Yoshiharu1962/ForestDesign-Mori-1/MORI_ICHI_1_SCH.pdf

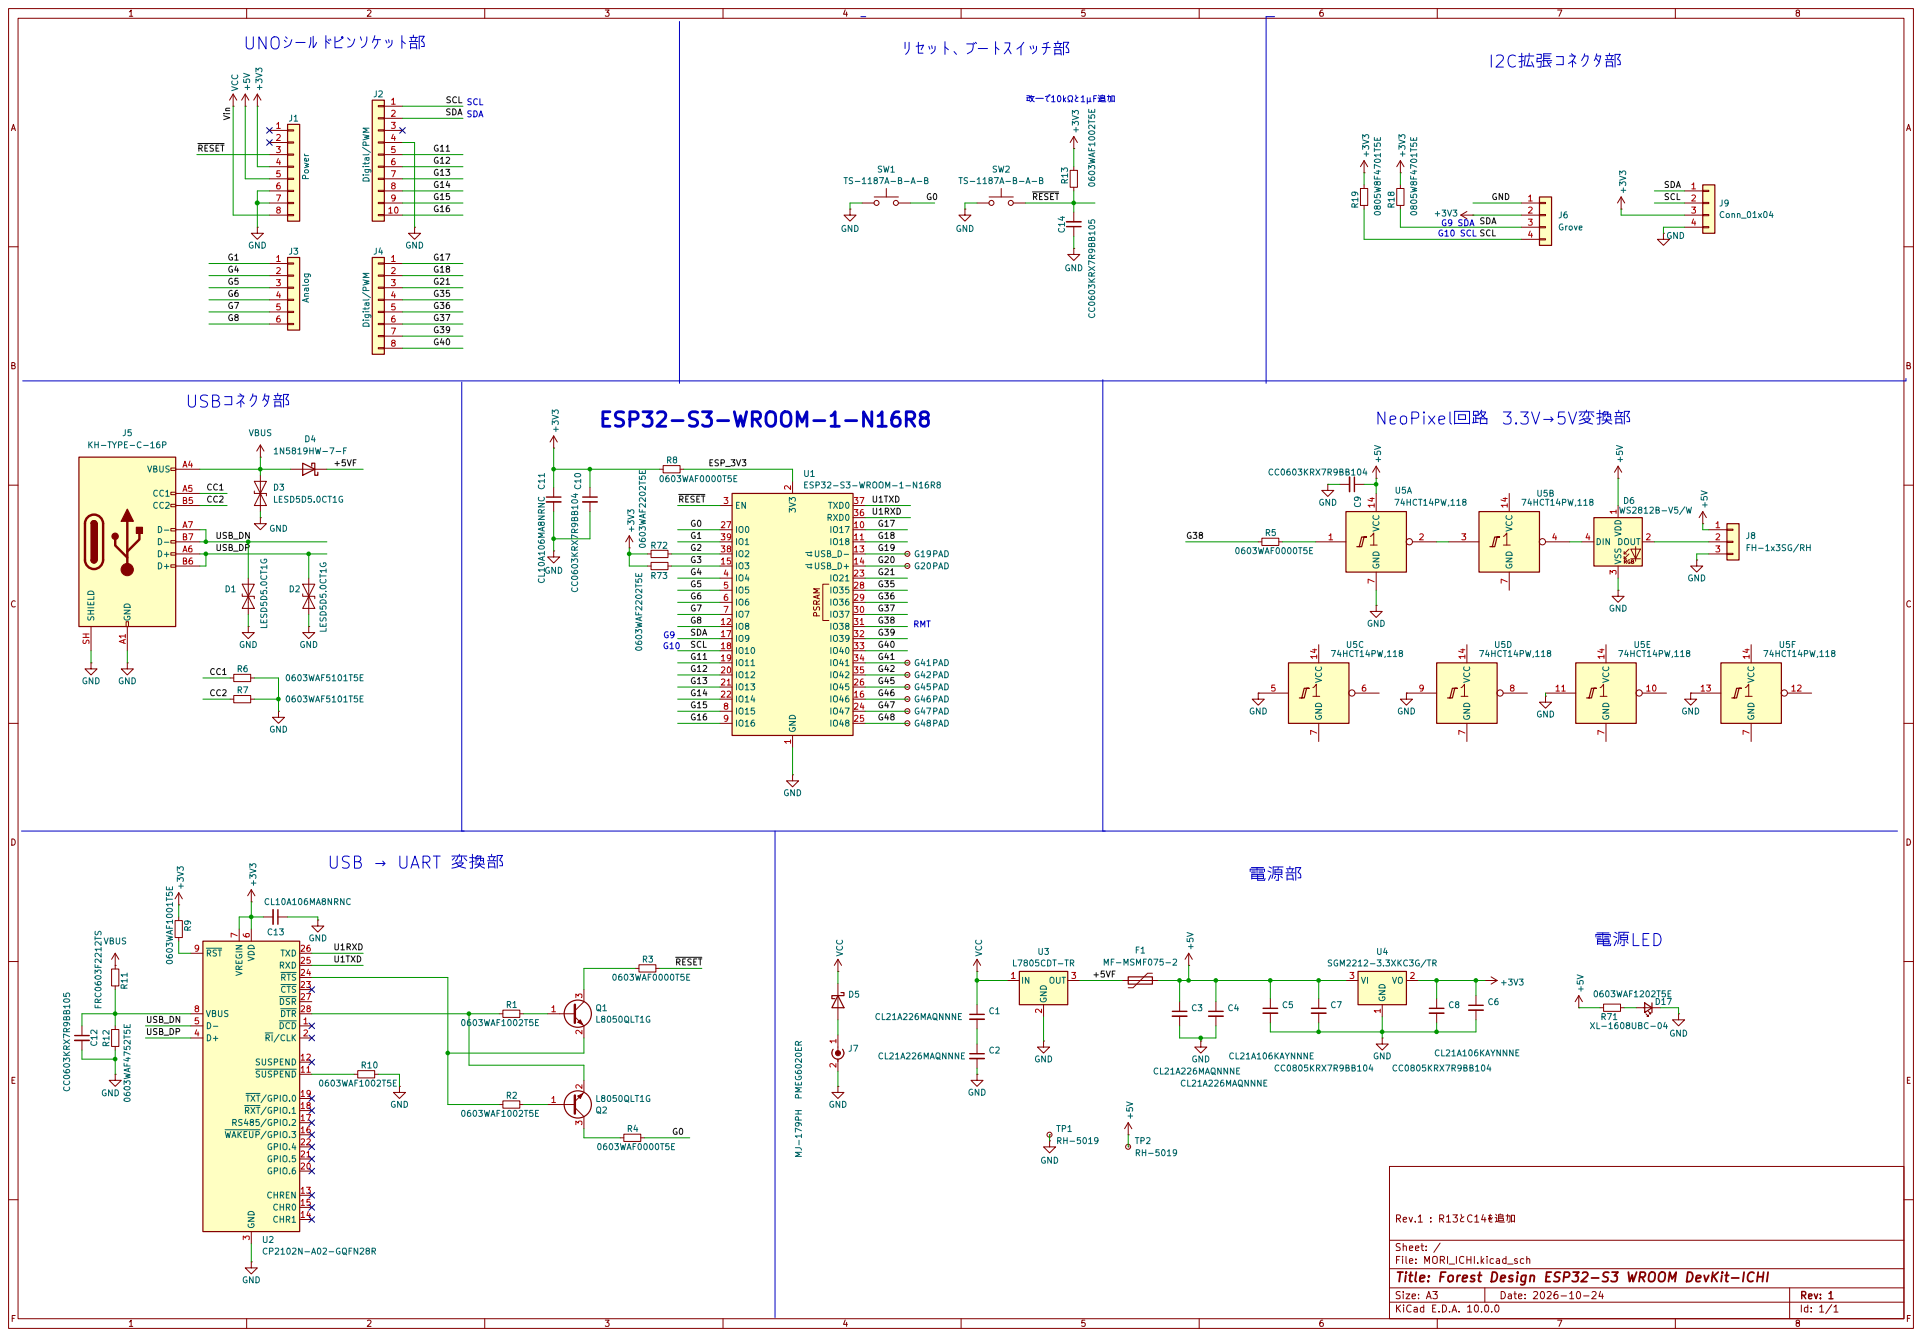
[picture p7: page 1]
