Yoshiharu1962/ForestDesign-Mori-1/(commit log)

2026-10-24 新規
    森壱式改一
    [MORI_ICHI.kicad_pcb, MORI_ICHI.kicad_sch]
2026-10-24 Create README.md
    新規ドキュメント登録
2026-10-24 森壱式改一回路図
    森壱式改一回路図
2026-10-24 森壱式改一回路図(PNG)
    森壱式改一回路図(PNG)
2026-10-24 森壱式修正内容とArudino IDE設定.mdの新規登録
    森壱式修正内容とArudino IDE設定.mdの新規登録
2026-10-24 森壱式初版修正記録
    森壱式初版修正記録
2026-10-24 Update 森壱式、修正内容とArduino IDE設定.md
2026-10-24 森壱式改一修正箇所イメージ
    森壱式改一修正箇所イメージ
2026-10-26 pin配置図追加
    pin配置図追加
2026-10-27 サンプルスケッチ新規登録
    森壱式用サンプルスケッチ新規登録
2026-10-27 森壱式用サンプルスケッチ
    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
2026-10-27 森壱式用サンプルスケッチ
    森壱式用サンプルスケッチ
    オンボードのNeoPixelが色を変えながら光ります。
    OLEDと外部NeoPixel（オンボード含め15個まで）も本サンプルスケッチで動作確認ができます。
2026-10-27 回路図を公開用に整理
    回路図を公開用に整理
